AK-Homberger/Seatalk-Autopilot-Remote-Control/README.md

# Seatalk Autopilot Remote Control

This repository shows how to build a Seatalk Autopilot Remote Control device based on an Arduino Pro Micro and a simple 433 MHz KeyFob. It has been tested successfully with different Raymarine autopilots.

My special thanks to users of www.segeln-forum.de for testing.

With the 433 MHz sender you can send -1 / +1 degree and -10 / +10 degrees. With a 6 key KeyFob or an additional one you can also send Auto/Standby commands.

Since version 1.5 the AP remote control reacts also on commands received via USB-Serial interface. Supported commands: "-1", "+1", "-10", "+10", "A" and "S". Both Newline and or CR are accepted at end of command from serial. This interfcae shall allow external applications like AvNav to control the AP functions.

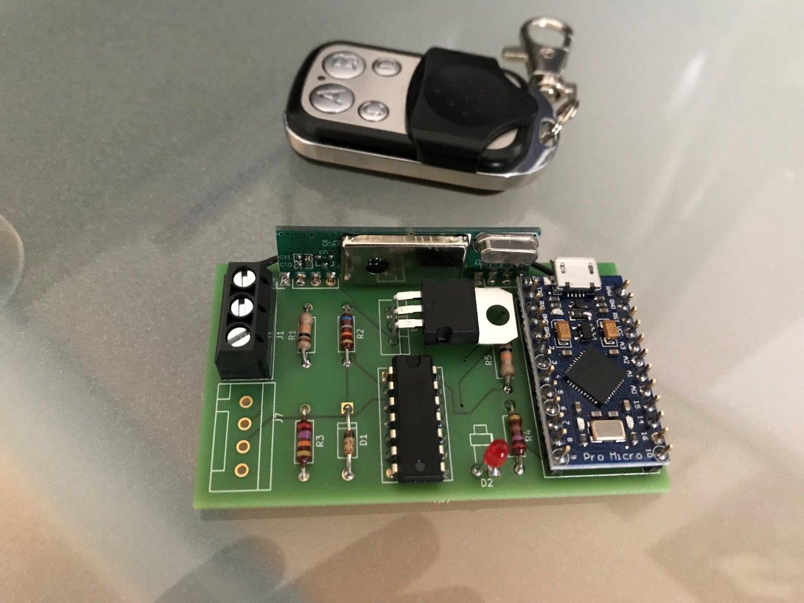
[picture p1: IMG_0857.JPG]
Autopilot Remote


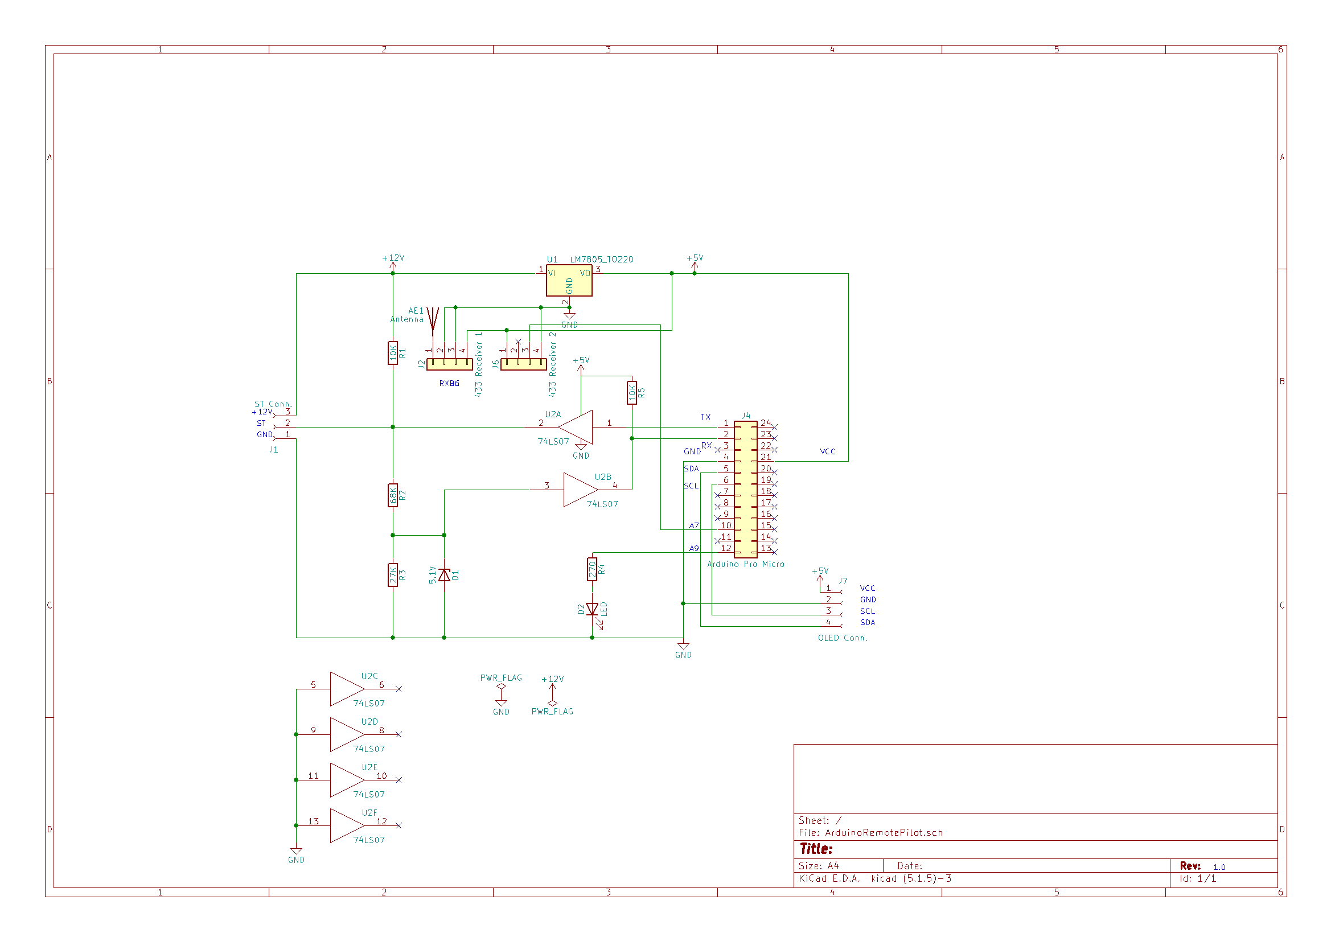
[picture p2: Remote Pilot Schematics.png]
Autopilot Schematic


# Hardware
The circuit diagram and the PCB layout are shown in the hardware section of this repository.

I made the PCB available at aisler.net (https://aisler.net/p/LCDCUVMF). Minimum number is three pieces for about 24 EUR. So it makes sense to buy once and share with others interested in the remote control.

The circuit implements mainly an interface between the Seatalk bus (12 Volt) and the Arduino (5 Volt).
The easiest way was to use the 74LS07 open collector driver device. This is much easier than most of the other implementations I have seen so far. The PCB also contains the voltage regulator (12-14 Volt from Seatalk bus to 5 Volt for the Arduino) and a 433 MHz receiver. Please select/buy the right ProMicro device (5 Volt). There are also 3.3 Volt devices available. But the 3.3 Volt devices will not work.

Please also select a high quality receiver which fits to the PCB design (RXB6, Superhet). As antenna please use a short wire (e.g. 17,3 cm).

The PCB also allows the connection of a standard OLED device (SSD1306) to show the current apparent wind speed. But this is optional.

The voltage regulator (7805) may get quite hot (90 mA * 9 Volt = 0,81 Watt). This is usually not a problem, because it within the specification of the 7805 (< 1,4 Watt).

An alternative which is not getting hot is the following replacement which has the same pin layout as the 7805: https://www.reichelt.de/de/en/dc-dc-converter-5-v-1-a-single-r-78e50-10-p177268.html?&nbc=1

A standard 4 button 433 MHz KeyFob is used to send (+1 / -1 degree) and (+10 / -10 degrees) course changes to the autopilot.
The used Seatalk codes are derived from Thomas Knauf (http://www.thomasknauf.de/rap/seatalk2.htm ). Many thanks for this excellent piece of work.

The software is sending a beep to the Raymarine devices (Seatalk alarm function). This helps to get a feedback regarding the recognition of of a pressed key. The LED on the PCB blinks in addition if keys are successfully recognised. This should also help with trouble shooting. It is also possible to connect an active 5 Volt buzzer to pin 20 (A2) and GND of the ProMicro.

Since version 1.1 it supports now also Auto and Standby remote control. You have to use a 6 button KeyFob or an additional 2 or 4 button remote for controling Auto/Standby function.

# Caution: Lighthouse III does not react on Seatalk Alarm 
MFDs with Lighthose II will react on the Seatalk alarm function with a short beep. Unfortunately, Lighthouse III is ignoring this alarm. If you prefer to use Lighthouse III then please connect an additonal buzzer to pin 20 of the ProMicro.

# Problem with some 7407 variants
It seems that there are different types of 7407 devices available with slightly different electrical charcteristics. See issue "R3 wrong value?" for details.
If you get a "Send Error" problem (with 12 Volt connected) then the solution is to lower the value of R3. It is important to check two voltages. With Seatalk signal line high (12 Volt) the voltage on pin 3 of 7407 (or alternatively on cathode of D1, which is easier to measure) should be above 2 Volt. When Seatalk pulled to GND (low) the voltage on pin 3 should be less than 0.8 Volt.

It's usually better to use the [74LS07](https://www.ti.com/lit/ds/symlink/sn74ls07.pdf) variant of the device, because it needs less power then the original TTL 7407. The [74HC07](https://www.dxdz-ic.com/upload/pdf/DX-74HC07.pdf) and 74HCT07 variants will not work in this szenario, because they don't implement a real "Open Collector" output and output voltage is limited to VCC (5 Volt here), but we need > 12 Volt for the Seatalk bus. Unfortunately, it looks like that some devices sold as 74LS07 are CMOS based equivalents with a diode from VCC to output that limits to 5 Volt.

# Software
The Seatalk communication is a 9 bit serial protocol. This is not directly supported from Arduino. But I found a working 9 bit hardware serial implementation. For convenience, I have added the working source code here, because there are different versions available (in github and elsewhere).

Caution: The 9 bit hardware serial implementaion is depending on the version of the Ardunio IDE and the ProMicro board information. IDE 1.6.13  and board version 1.6.15 are working with the files in "NewHWSworking". Later versions (e.g. 1.8.10) changed the hardware serial implementation and the 9 bit changes will work work with files in "HardwareSerial9bit". For the Leonardo board please use the **Arduino AVR Boards** version 1.8.3. Since version 1.8.4 the code has changed again and the 9 bit implementation is not working.

For newer IDE versions the three files from "HardwareSerial9bit" (or "NewHWSworking" for older IDE) have to be copied into the Arduino directory on your local PC e.g.: "C:\Program Files (x86)\Arduino\hardware\arduino\avr\cores\arduino".

As Arduino board for the ProMicro you can either use the standard Arduino "Leonardo" board information or the ProMicro  SparkFun implementation: https://learn.sparkfun.com/tutorials/pro-micro--fio-v3-hookup-guide . Both will work.

Make sure that you install the ProMicro Board Addon using the Board Manager as described in the hookup guide: https://learn.sparkfun.com/tutorials/pro-micro--fio-v3-hookup-guide#windows_boardaddon

The software is using several additional Arduino libraries (RCSwitch, Adafruit_GFX, Adafruit_SSD1306). These libraries have to be downloaded and installed. The easiest way is to add the libraries with the IDE Library Manager.

- https://github.com/sui77/rc-switch
- https://github.com/adafruit/Adafruit-GFX-Library
- https://github.com/adafruit/Adafruit_SSD1306

# Programming the 433 MHz KeyFob

You should change the four codes in the software to individual random numbers. The same codes have to be copied to the "_433_Programming_New.ino". Only for programming you will also need a 433 MHz sender connected to the ProMicro.
I used a ProMicro on a "bread board" to program the codes. 

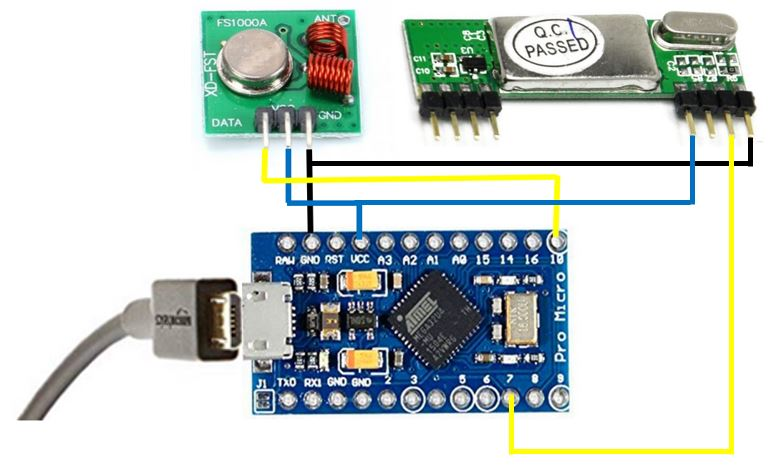
[picture p3: Programming connections.JPG]
Connections


Send each code individually and programm the keys of the remote according to the programming description of your KeyFob. Press "Send" button in serial console for next key. 

Key 1 = button A = -1 degree

Key 2 = button B =  +1 degree

Key 3 = button C = -10 degrees

Key 4 = button D = +10 degrees

If you use Auto/Standby function you also have to program the two additional buttons accordingly. After programming you can check directly if codes are programmed correctly. Just press the key on the remote and check if the shown value is correct.

Have fun with the remote control.

Please be aware that this repository is only for educational purpose, to learn how to use the Seatalk protocol. Use it on your own risk and do not use it for critical systems in real life environments.

# Parts:

- J1  Connector, AKL 101-03, 3-pin, 5,08 mm [Link](https://www.reichelt.com/index.html?ACTION=446&LA=0&nbc=1&q=akl%20101-03)
- J2  RXB6 433 Mhz receiver [Link](https://www.makershop.de/en/module/funk/rxb6-433mhz-antenne/)
- J4  Arduino ProMicro, 5 Volt [Link](https://eckstein-shop.de/HIMALAYA-basic-Pro-micro-5V-16MHz-Arduino-mini-Leonardo-compatible-board)  oder [Link](https://www.amazon.de/Micro-ATmega32U4-Arduino-Leonardo-%C3%A4hnlich/dp/B01D0OI90U)
- U1  7805  (alternative: 173950578 MagI3C DC-DC Power Module) [Link](https://www.reichelt.com/de/en/voltage-regulator-up-to-1-5-a-positive-to-220--a-7805-p23443.html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) or [Link2](https://www.reichelt.de/de/en/dc-dc-converter-5-v-1-a-single-r-78e50-10-p177268.html?&nbc=1)
- U2  7407N (alternative: 74LS07) [Link](https://www.reichelt.com/de/en/index.html?ACTION=446&LA=446&nbc=1&q=7407n) or [Link](https://csd-electronics.de/ICs/Logik/74LS/74LS07-DIP14::283.html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)
- D1  Zenerdiode 5.1 Volt (0.5 Watt) [Link](https://www.reichelt.com/de/en/zener-diode-0-5-w-5-1-v-zf-5-1-p23137.html?&trstct=pos_0&nbc=1)
- D2  LED, rot, 3 mm [Link](https://www.reichelt.com/de/en/led-3-mm-low-current-red-led-3mm-2ma-rt-p21626.html?&trstct=pos_8&nbc=1)
- R1,R5 Resistor 10 KOhm, 1/4 watt [Link](https://www.reichelt.com/de/en/carbon-film-resistor-1-4w-5-10-kilo-ohms-1-4w-10k-p1338.html?&nbc=1)
- R2  Resistor 68 KOhm, 1/4 watt [Link](https://www.reichelt.com/de/en/carbon-film-resistor-1-4-w-5-68-kohm-1-4w-68k-p1462.html?&nbc=1)
- R3  Resistor 27 KOhm, 1/4 watt [Link](https://www.reichelt.com/de/en/carbon-film-resistor-1-4-w-5-27-kohm-1-4w-27k-p1392.html?&nbc=1)
- R4  Resistor 270 Ohm, 1/4 watt [Link](https://www.reichelt.com/de/en/carbon-film-resistor-1-4-w-5-270-ohm-1-4w-270-p1390.html?&nbc=1)

Optional:
- OLED display,  096 inch, I2C [Link](https://www.makershop.de/en/display/oled/096-oled-display-blau/)
- Buzzer  [Link](https://www.makershop.de/en/module/audio/aktiver-summer/) or [Link2](https://www.conrad.de/de/p/makerfactory-mf-6402168-aktiver-summer-2134056.html)

For programming:
433MHz transmitter [Link](https://www.makershop.de/en/module/funk/superheterodyne-433-mhz-sender/) or [Link2](https://www.makershop.de/en/module/funk/433-sender-empfaenger/)

Remote Control (KeyFob):  [Link](https://www.amazon.de/XCSOURCE-Elektrische-Universal-Garagentor-Fernbedienung-Ersatz-Schl%C3%BCsselanh%C3%A4nger-HS641/dp/B01KJRGMHI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) or [Link2](https://www.amazon.de/EasyULT-Handsender-Fernbedienung-Automatische-Garagentor%C3%B6ffner/dp/B0829WXGR5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) or [Link3](https://de.aliexpress.com/item/4000850169472.html?spm=a2g0s.9042311.0.0.15244c4dubWD35)

# Updates:

- Version 1.5 - 16.12.20: Added command receive from USB-Serial to allow control from AvNav.
- Version 1.4 - 28.11.20: Changed R2 and R3 back to 68 KOhm / 27 kOhm. 6.8 KOhm would impact the Seatalk high voltage level too much.
- Version 1.4 - 27.11.20: Changed R2 and R3 to 6.8 KOhm to eliminate problems with some 74LS07 devices (see issue "R3 wrong value?" for details).
- Version 1.4 - 27.07.20: Use of millis() funtion to avoid delay() and timer counter in loop(). Improved detection of 433MHz keys.
- Version 1.3 - 13.12.19: Added definition for certain OLED displays that require this to work properly.
- Version 1.2 - 21.09.19: Added buzzer support on pin 20 (active 5 Volt buzzer works without additional transistor).
- Version 1.1 - 03.08.19: Added support for Auto and Standby (Key 5 and 6).
- Added new programming code (_433_Programming_New.ino) to simplify programming of KeyFob without recompiling and upload for each key.
