AK-Homberger/Seatalk-Autopilot-Remote-Control/AP-Remote-Hardware/AP Remote-pcb.pdf

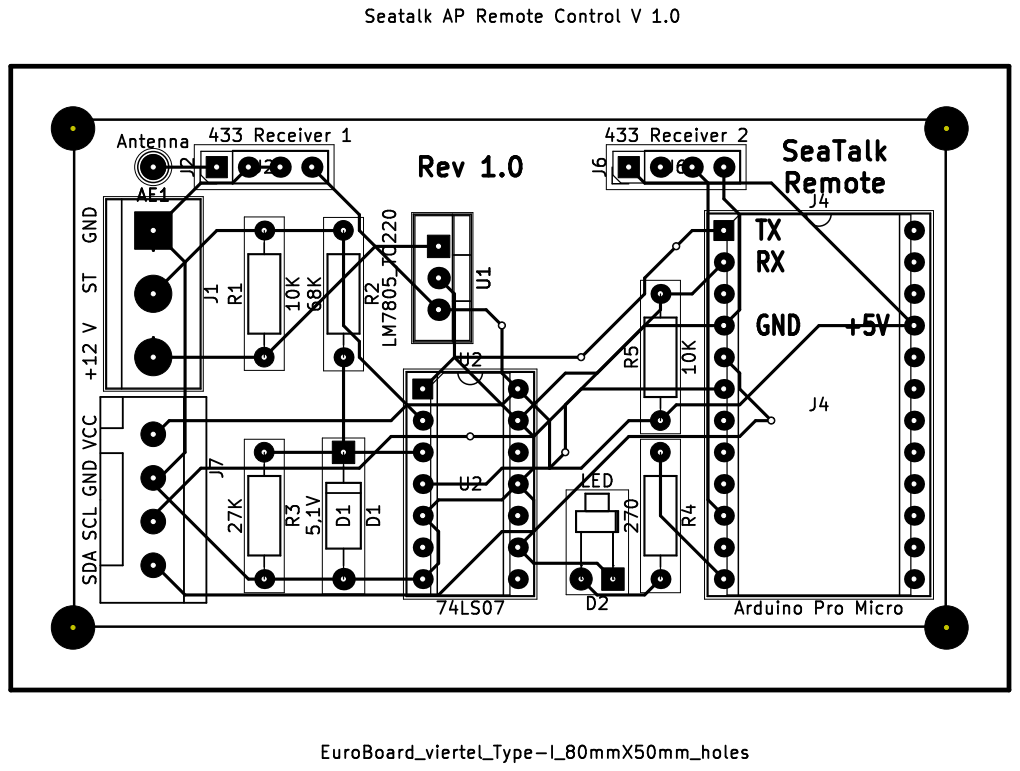
[picture p4: page 1]
