AK-Homberger/Seatalk-Autopilot-Remote-Control/AP-Remote-Hardware/AP Remote-sch.pdf

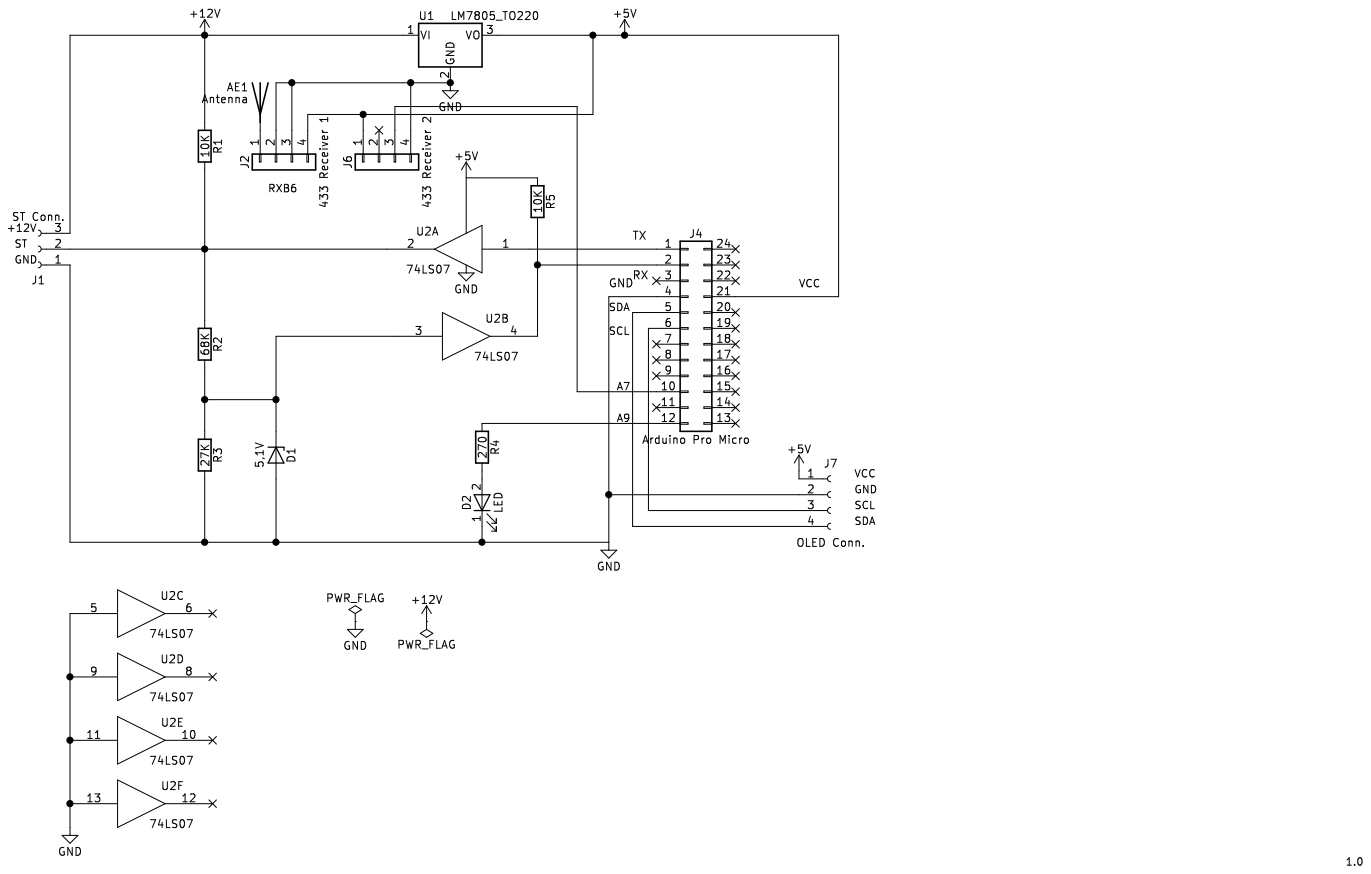
[picture p5: page 1]
