AK-Homberger/Seatalk-Autopilot-Remote-Control/(threads)

Thread 2 (2020-11-06):

Seatalk codes X-value

TomHW, 2020-11-06:
Hi Andreas,
in the ArduinoPilotMicro433WindNG.ino I found the codes of the RF remote control and I compared it to the codes from Thomas Knauf’s website. I got the impression that you are sending the codes of the Autopilot (X=2) and not the codes of the remote control (X=1). Are there special reasons for this or doesn't it matter which value you take for X?
Thanks and best regards
Thomas

AK-Homberger, 2020-11-07:
Hi Thomas,
The only reason is that X=2 worked for me. But it's free software. Feel free to test other values and see if it's working for your AP.
Regards,
Andreas

TomHW, 2020-11-07:
Hi Andreas,
thanks for the fast reply. I will rebuild the circuit and test with different settings.
Regards
Thomas

Closed 2020-11-07.

Thread 3 (2020-11-14):

Pro Micro Board has different dimensions

TomHW, 2020-11-14:
I ordered a Pro Micro Mini USB Board 5 V from Makershop.de and while assembling the board I discovered that the Pro Micro Board does not fit. It is longer and wider (4.4 × 2.5 × 0.8 cm). One advantage is the better anchoring of the USB socket. However, the Pro Micro Board does not match the current RF board.

Regards
Thomas
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

AK-Homberger, 2020-11-15:
Many thanks for reporting the issue. I changed the link to a shop with a Pro Micro with the right dimension.

Closed 2020-11-15.

Thread 4 (2020-11-25):

R3 wrong value?

TomHW, 2020-11-25:
I built three remote controls and all of them came up with "SendError" in the display. The reason was too high voltage at pin 3 of IC 74LS07. After replacing R3 (27 k) from the voltage divider with 2.7 k everything was fine. Maybe the circuit diagram and the parts list is missing a decimal point?

AK-Homberger, 2020-11-25:
Hi TomHW,
What do you mean with "too high"?
With 12 V the Voltage on pin 3 should be about 3 Volt which not too high but exactly what it should be. And the Zener Diode 5.1 V would protect the 73LS07 anyway. Can check also the other resistors.
Regards,
Andreas

Calculation: 12/(10K+68K+27K) = 0.14 mA. And 0.14mA * 27K = 3.08 V.

TomHW, 2020-11-26:
Hi Andreas,
the low value is the problem. Pulling the Seatalk line to GND gives 1.6 V on pin 3 and the output on pin 4 is on High. With the reduced R3 the voltage on pin 3 is 1.2 V and pin 4 goes down to Low. It's strange and my only explanation for the voltage is the input of the 74LS07.
Regards
Thomas

AK-Homberger, 2020-11-26:
Hi Thomas,
I can't reproduce the reported effect with my devices. With Seatalk to GND I do have 0,5 V on pin 3. That shows a current of 0.025mA through the then parallel connected resitors R2/R3 (19,3K). That was typical for a devices I build so far. But after a closer look to the datasheet of the 74LS07, I identified that the maximum of IIL (the current from input when pulled to low) is specified with 0,2mA. It looks to me that your 74LS07 is closer to the maximum. If lowering the value of R3 works for you that leave it this way. But my recommendation is to re-calculate all three resistors to have sure high and low levels on pin 3.
But many thanks for reporting the issue. I will update the description accordingly.
Regards
Andreas

TomHW, 2020-11-26:
Hi Andreas,
R2/R3 with R3=2k7 and then parallel is 2k6. With 1.2 V there must be a current of 0,46 mA what exceeds the IIL maximum more than twice. But I will keep the current R3 and hope that it is stable over a wider temperature range.
Regards
Thomas

Closed 2020-11-26.

Thread 12 (2023-01-07):

Tested device list

jekil, 2023-01-07:
Readme mentions how the project was tested on several devices.
It would be nice to include a list of them.

Thanks so much for this awesome project.

AK-Homberger, 2023-01-08:
What devices you are referring too? Autopilots? MFDs? In general it will work with all Seatalk1 based autopilots. On newer MFDs the beep will not work.

jekil, 2023-02-05:
Autopilots.

AK-Homberger, 2023-02-06:
All autopilots compatible with the original remote controller (S110, Smart Controller) should work. Either directly with Seatalk or with the converter also SeatalkNG.

Closed 2023-05-03.

Thread 13 (2023-02-10):

CMOS  M74HC07 Issue

philipb78, 2023-02-10:
Great project , been playing with different interfaces to Seatalk . I  am new to electronic circuits although am a software developer by trade.

I am most likely doing something wrong but the MC74HC07 chip works great for receive but TX isnt working . I hook up pin 1 and seeing the pull down signal  ok on transmit (it's an esp32 so 3.5v rather than 5v ) but pin 2 always stays at 12v (isolated from other seatalk devices ) . It was a good exercise i'm learning to read datasheets. I thought the problem was the 3.3v signal but it seems it's the high voltate the other side. Seems the MC74HC07 max is VCC (5v in my case )? I think maybe there is a high voltage protection at play? I am going to try to source some of the ones you recomended originally as the datasheet for them says up to 30v .

Thanks again for sharing !

Closed 2023-06-01.

Thread 15 (2023-05-31):

READ SEALTALK DATA with USB

ignamendi21, 2023-05-31:
Hello, Using this project, would it be posible to read the seatalk data using the usb and defining se serial comunicaction (nm0183) in openplotter/signalK¿??

AK-Homberger, 2023-06-01:
You can read Seatlak messages in the same way as I did for the wind data for other codes. Then you can assemble NMEA 0183 messges and send the result either via USB-Serial or with another pin (e.g. with the Softwareserial library).

Closed 2023-11-03.

Thread 17 (2024-02-21):

Gerber file

thomasnisole, 2024-02-21:
Hello @AK-Homberger , is it possible to have gerber file to make pcb on jlcpcb ?

Thank you in advance.
Thomas.

AK-Homberger, 2024-02-26:
Hi,I don’t have gerber files for this project.But with the project files for KiCad on GitHub, you can create that files by yourself.Regards,AndreasAm 21.02.2024 um 21:02 schrieb Thomas Nisole ***@***.***>:
Hello @AK-Homberger , is it possible to have gerber file to make pcb on jlcpcb ?
Thank you in advance.
Thomas.

—Reply to this email directly, view it on GitHub, or unsubscribe.You are receiving this because you were mentioned.Message ID: ***@***.***>

thomasnisole, 2024-02-26:
Hello @AK-Homberger , thank you for your response. But i don't find any kicad file on the repository ?

Thank you.

thomasnisole, 2024-02-27:
Perfect, thank you @AK-Homberger

thomasnisole, 2024-04-10:
Hello @AK-Homberger, sorry to insist but would it be possible to have the gerber files? Thanks.

AK-Homberger, 2024-04-11:
I don't have any gerber files. But you can create them by yourself with KiCad.

Closed 2025-06-18.

Thread 18 (2024-08-03):

ST2000+ not responding to commands

Benkkumie, 2024-08-03:
Hello,

I've been trying to build this remote controller for a while now. I have with difficulties finally reached a stage where I don't get send error or collision anymore (needing to ground unused input pins on 74LS07 seemed to be the solution for me) and I am receiving what I'm sending. Still I can't get my ST2000+ to make any moves in Auto or Standby.

I'm currently running IDE version 1.6.13 and AVR boards 1.6.15 and "NewHWSworking" for 9 bit serial, due to not being able to verify with IDE 1.8.10 and AVR boards 1.8.3 (getting error SERIAL_9N1 was not declared in this scope even though I copied the correct 9 bit hardware serial implementation for that version into the specified file). I've decided to use 6 buttons connected to Pro Micro I/O pins, instead of using a 433MHz remote. The hardware is layed out on a perfboard and I am 99% sure the connections are correct. I've compared it to the KiCad file and everything seems to be just like it, except not having the 433MHz and Oled connections. Also getting 2,92 volts on 74LS07 pin 3 when ST not pulled to ground, and 0,51v when it is pulled to ground. So hardware seems fine. The connection from 74LS07 pin 2 to the SeaTalk pin on the ST2000+ is fine, so it's not like a wire is broken or something.

I've also modified the code a bit and it is included in the attachment.  I've removed display and remote code due to not needing it and added button inputs and made them send the datagrams.

I've also tried different datagrams from Thomas Knauf's website but not getting any luck with that.

What might be the problem? Considering on getting an oscilloscope to dive deeper into what my circuit is outputting.
[code.txt](https://github.com/user-attachments/files/16483098/code.txt)

Benkkumie, 2024-08-04:
How embarassing, the remote is working now. It seems that the power supply I was using on the bench wasn't giving enough voltage, measuring 10 volts on seatalk pin and that seemed to be the problem. Still currently working only in Auto, but I have to look into that a bit more, that is still all I need for my sailing.

But afterall my biggest problem seemed to be ungrounded unused input pins on the 74LS07. After that fix everything seemed to start working. So people having issues maybe should look into that.

Closed 2024-08-04.

Thread 19 (2024-10-25):

SendError on Seatalk

jeickmann, 2024-10-25:
Hi,

first of all, thanks for sharing this great project. I got everything setup and I am able to receive commands from the remote onto the pro micro. Unfortunatly, I seem to be unable to send anything on the seatalk bus, I always get "sendError".

Actually, I used the LED for debugging (turning it on on sendError and off when sendDatagram succeeeds), as somehow I can not get the serial monitor to work when connected to 12V and I do not have an OLED display set up.

Even just the regular sendDatagram calls for BeepOff cause this.

I checked the voltages and I get about 3,9 V / 0 Volt respectivly on the D1-Cathode when pulling Seatalk High or Low respectivly.

Any other ideas on what to debug?

Best and I really appreciate any help you can give.

Jan

AK-Homberger, 2024-10-27:
You should test with 12 Volt and no connection to the Setalk-Bus first. As long as you get Send Errors then, it will not work because the board is not able to receive what it sends. You can also try a different  74LS07 device. It looks like some devices are not really LS devices (or CMOS equivalent).

jeickmann, 2024-10-28:
Ok, thanks, good news that I can test without anything hooked up. Let me check tonight, I will also try to source a different 74LS07. I will report back.

Closed 2024-11-10.
