AK-Homberger/Seatalk-Autopilot-Remote-Control/(commit log)

2019-09-20 Added missing +10 Code.
    [ArduinoPilotMicro433WindNG.ino]
2019-09-20 Added missing +10 Code
    [ArduinoPilotMicro433WindNG.ino]
2019-09-21 Added Buzzer on pin 20 to give accoustical feedback when now buzzer in AP available.
    [ArduinoPilotMicro433WindNG.ino]
2019-09-25 Corrected missing Beep() in "-1"
    [ArduinoPilotMicro433WindNG.ino]
2019-09-27 New HarwareSerial files for current IDE (1.8.x)
2020-07-27 Use of millis() funtion to avoid delay() and timer counter in loop()
    [ArduinoPilotMicro433WindNG.ino]
2024-03-01 Added KiCad project files.
